clawntl/EBS-SBR/(list of files, cad)

Other CAD files:
hardware/CAD/EBS-SBR.step
