clawntl/EBS-SBR/firmware/src/SerialCommands.cpp

#include "SerialCommands.h"

#include <Arduino.h>

#include "RobotParams.h"
#include "CANConfig.h"
#include "MotorDrivers.h"

namespace {
char serialBuff[32];
#define serialBuff_len sizeof(serialBuff) / sizeof(char)
} // namespace

void processSerialCommands() {
    while (Serial.available() > 0) {
        // Clear the buffer
        memset(serialBuff, 0, serialBuff_len);

        Serial.readBytesUntil('\n', serialBuff, serialBuff_len);
        Serial.println(serialBuff);

        // Tokenize the received char array to split at the whitespaces
        // Split on spaces/tabs and also CR/LF: the PlatformIO monitor (and
        // most terminals) end lines with CR+LF, and readBytesUntil('\n')
        // leaves the CR in the buffer
        char* token = strtok(serialBuff, " \t\r\n");
        uint8_t idx = 0;

        char *outArray[10];
        while (token != NULL && idx < 10) {
            outArray[idx] = token;
            idx++;
            token = strtok(NULL, " \t\r\n");
        }
        uint8_t outArrayLength = idx;

        // Empty line: outArray[0] would be uninitialised.
        if (outArrayLength == 0) continue;

        // if (!strcmp(outArray[0], "LC")) {
        //     leftTargetCurrent = atof(outArray[1]);
        //     constrain(leftTargetCurrent, -2, 2);

        //     //sendFloat(CMD_TARGET_CURRENT, leftTargetCurrent, LEFT_MOTOR_CAN_ADDR);
        // }

        // else if (!strcmp(outArray[0], "RC")) {
        //     rightTargetCurrent = atof(outArray[1]);
        //     constrain(rightTargetCurrent, -2, 2);
        //     //sendFloat(CMD_TARGET_CURRENT, rightTargetCurrent, RIGHT_MOTOR_CAN_ADDR);
        // }

        if (!strcmp(outArray[0], "SP")) {
            angleSetPoint = atof(outArray[1]) * DEG_TO_RAD;
            Serial.println(angleSetPoint);
        }

        else if (!strcmp(outArray[0], "DA")) {
            deactivationAngle = atof(outArray[1]);
            Serial.println(deactivationAngle);
        }

        else if (!strcmp(outArray[0], "K0")) {
            K[0] = atof(outArray[1]);
            Serial.println(K[0]);
        }
        else if (!strcmp(outArray[0], "K1")) {
            K[1] = atof(outArray[1]);
            Serial.println(K[1]);
        }
        else if (!strcmp(outArray[0], "K3")) {
            K[3] = atof(outArray[1]);
            Serial.println(K[3]);
        }
        else if (!strcmp(outArray[0], "K4")) {
            K[4] = atof(outArray[1]);
            Serial.println(K[4]);
        }

        else if (!strcmp(outArray[0], "CA")) {
            alpha = atof(outArray[1]);
            Serial.println(alpha);
        }

        // Motor driver status
        else if (!strcmp(outArray[0], "MS")) {
            const char *names[2] = { "Left", "Right" };
            for (int s = 0; s < 2; s++) {
                const MotorDriverInfo m = getMotorDriverInfo((MotorSide)s);
                Serial.printf("%-5s: %-8s flags 0x%02X%s%s%s%s  start attempts %u",
                              names[s], motorLinkName(m.link), m.flags,
                              (m.flags & DRIVER_FLAG_COMMAND_TIMEOUT)  ? " cmd-timeout" : "",
                              (m.flags & DRIVER_FLAG_CALIBRATION_USED) ? " stored-align" : "",
                              (m.flags & DRIVER_FLAG_INVERTED)         ? " inverted" : "",
                              (m.flags & DRIVER_FLAG_DRV_FAULT)        ? " DRV-FAULT" : "",
                              m.startAttempts);
                if (m.lastError) Serial.printf("  last error: %s (%lu s ago)", driverErrorName(m.lastError), (unsigned long)(m.lastErrorAgeMs / 1000));
                Serial.println();
            }
        }

        // Motor retry: let a driver that gave up starting be tried again
        else if (!strcmp(outArray[0], "MR")) {
            resetMotorStartAttempts();
            Serial.println("Motor start attempts reset");
        }

    }
}
