clawntl/EBS-SBR/firmware/src/ByteUtils.h

#pragma once

#include <Arduino.h>

// Convert a float to a byte array using MSB first (big-endian) order
inline void float2bytesMSB(float val, uint8_t *bytes) {
    // Copy the raw bits of val into an integer so can perform
    // bitwise operations
    uint32_t valAsInt;
    memcpy(&valAsInt, &val, sizeof(float));

    // Extract the bytes in big-endian (MSB-first) order
    bytes[0] = (valAsInt >> 24) & 0xFF;
    bytes[1] = (valAsInt >> 16) & 0xFF;
    bytes[2] = (valAsInt >> 8)  & 0xFF;
    bytes[3] = (valAsInt >> 0)  & 0xFF;
}

// Convert a byte array to a float using MSB first (big-endian) order
inline float bytes2floatMSB(const uint8_t *bytes) {
    // Readt the bytes in big-endian (MSB-first) order
    uint32_t valAsInt =
        ((uint32_t)bytes[0] << 24) |
        ((uint32_t)bytes[1] << 16) |
        ((uint32_t)bytes[2] << 8)  |
        ((uint32_t)bytes[3]);

    // Copy the raw bits to a float and return
    float val;
    memcpy(&val, &valAsInt, sizeof(float));

    return val;
}
