clawntl/EBS-SBR/(commit log)

2026-11-11 Add firmware, images and README
    Controller-Board (ESP32-S3, LQR balance) and Driver-Board (STM32G431,
    SimpleFOC) PlatformIO projects, robot images, and a project README.
2026-11-11 README: link BLDC-Driver repo for driver board details
2026-11-11 Add full robot CAD STEP file
    [EBS-SBR.step]
2026-11-12 remove drive board fw
    - remove driver board fw as that has it's own repo: https://github.com/clawntl/BLDC-Driver
    - move controller fw in Firmware folder
2026-11-12 Motor driver supervision, OLED status display, fixed-rate current sender
    Uses the status/reply/error frames added to the BLDC_Driver firmware (board_settings branch). REQUIRES that driver firmware: older drivers send no heartbeat, so the host would never start them.
    Motor driver supervision (new: src/MotorDrivers.*)
    - Tracks each driver from its CMD_DRIVER_STATUS heartbeat (0x03, every 100 ms), the CMD_START_FOC reply and CMD_ERROR frames.
    - Links: offline (no heartbeat for 500 ms), starting, idle, running, fault, gave up.
    - Task_motorSupervisor sends CMD_START_FOC to any driver that reports idle or fault, one driver at a time (alignment moves the wheel and draws current). This replaces the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
    [CANConfig.h, CanBus.cpp, CanBus.h, Display.cpp, Display.h, LQRControl.cpp, LQRControl.h, MotorDrivers.cpp]
2026-11-12 Run LQR in lock-step with the IMU and send currents directly; fix IMU rate
    Task_LQR used to spin in a busy loop at the same priority (1) as every other task on core 1. It recomputed the same output thousands of times between IMU samples.
    Because equal-priority tasks that become ready only run at the next 1 ms tick, it also delayed the IMU sampling and CAN sends by up to ~1 ms.
    A separate 500 Hz task then sent the latest currents, unsynchronised with the LQR, adding up to another 2 ms. Sample-to-CAN latency was therefore about 0-3 ms and varied from frame to frame.
    IMU -> LQR synchronisation (src/IMUDriver.*, src/LQRControl.*)
    - Task_BMI160 wakes the LQR task (xTaskNotifyGive) after each com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
    [CanBus.cpp, CanBus.h, Display.cpp, IMUDriver.cpp, IMUDriver.h, LQRControl.cpp, LQRControl.h, RobotParams.cpp]
2026-11-12 Make web interface a captive portal (fixes Android not loading)
    Rework the AP web interface to use the same approach as the
    esp32-captive-portal demo, which loads on every device, including the
    Android phone that couldn't open the old interface.
    Firmware (WebInterface.cpp/.h):
    - Add a wildcard DNSServer and set the AP as gateway + DNS via
    softAPConfig. Previously DNS lookups sent to 192.168.4.1 went
    unanswered, which most likely left Android unable to classify the
    network and caused Chrome's ERR_TOO_MANY_RETRIES.
    - Redirect OS connectivity probes (generate_204, hotspot-detect.html,
    connecttest.txt, etc.) and unknown paths to http://192.168.4.1/ so
    the phone opens its sign-in sheet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
    [WebInterface.cpp, WebInterface.h]
